patricktokeeffe/rea-nh3-sampler/doc/images/tubing_connections.png

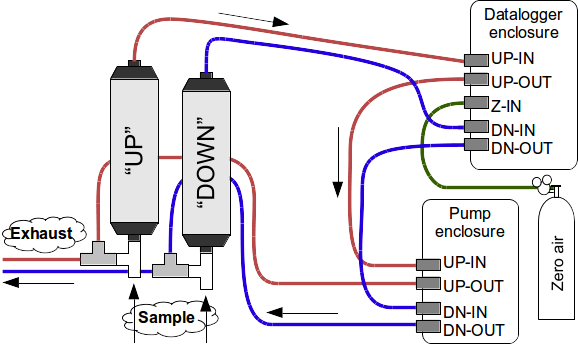
doc/images/tubing_connections.png
