patricktokeeffe/rea-nh3-sampler/doc/images/valve_detail.png

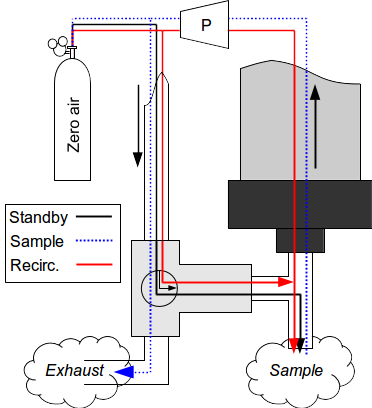
doc/images/valve_detail.png
