patricktokeeffe/rea-nh3-sampler/doc/bill_of_materials.ods

Bill of Materials |  |  | to verify
 | Quantity | Description | Model/Part # | Vendor (Mnfctr, if diff.) | Location
 | 1 | Anemometer, 3D ultrasonic | CSAT3 | Campbell Scientific Inc | Logan, UT
 | 1 | Infrared CO2/H2O analyzer, open-path | LI-7500 | LI-COR Inc. | Lincoln, NE
 | 1 | Temperature/relative humidity probe | HMP45AC | Campbell Scientific Inc (Vaisala) | Logan, UT
 | 1 | Pump, dual-head | R221-AT-AA1 | Air Dimensions | Deerfield Beach, FL
 | 2 | Flow controller, thermal/mass-based, 0-10 sLPM |  | Omega
 | 1 | Flow controller, thermal/mass-based, 0-0.5 sLPM |  | Omega
 | 2 | Valve, solenoid, 3-way, 12V, fast-acting | 091-0094-900 | Parker Hannifin Corp. | Cleveland, OH
 | 1 | Valve, solenoid, 2-way NC, 12V | C-01367-70 | Cole Parmer | Vernon Hills, IL
 | 2 | Tee, PTFE, 1/4 tube x 1/8 MNPT x 1/4 tube | K-31320-35 | Cole Parmer | Vernon Hills, IL
 | 2 | Fitting, quick-disconnect | K-31404-09 | Cole Parmer | Vernon Hills, IL
 | 1 | Datalogger | CR5000 | Campbell Scientific Inc | Logan, UT
 | 1 | Power supply, 13.8Vdc, 10A | ? | Radioshack
 | 1 | Relay rack, 4ch | G4PB4R | Opto 22 | Temecula, CA
 | 4 | Relay, 5Vdc / 60Vdc | G4ODC5 | Opto 22 | Temecula, CA
 | 1 | Relay, solid state, 3-32Vdc / 10A @ 120Vac | 120D10 | Opto 22 | Temecula, CA
 | 1 | Pressure sensor, 0-15 psig, 0-5V | PX309-015G5V | Omega (Omegadyne Inc) | Stamford, CT
 | For pair of housings and four pairs of denuders:
 | 2 | Inlet Cap | 30-006127 | Thermo Scientific | Waltham, MA
 | 2 | PM2.5 inlet, 10L/min, PTFE | 55-006038-T100 | Thermo Scientific | Waltham, MA
 | 2 | Impactor plate | 55-006040 | Thermo Scientific | Waltham, MA
 | 2 | Long length housing (holds 5) | 55-008909 | Thermo Scientific | Waltham, MA
 | 4 | Honeycomb denuder, glass | 55-006171 | Thermo Scientific | Waltham, MA
 | 6 | Stand-off, glass | 24-006041 | Thermo Scientific | Waltham, MA
 | 10 | Spacer, nylon | 36-006042 | Thermo Scientific | Waltham, MA
 | 2 | Spring | 30-006044 | Thermo Scientific | Waltham, MA
 | 6 | 47mm filter stage assembly, Teflon | 55-006169 | Thermo Scientific | Waltham, MA
 | 2 | 47mm filter holder, thread exit | 36-006048 | Thermo Scientific | Waltham, MA
 | 2 | Filter holder housing (outlet) | 55-006049-0004 | Thermo Scientific | Waltham, MA
 | 2 | Male fitting for thread exit | 32-003178 | Thermo Scientific | Waltham, MA
 | 2 | Outlet plug | 30-006128 | Thermo Scientific | Waltham, MA
