patricktokeeffe/rea-nh3-sampler/doc/images/system_components.png

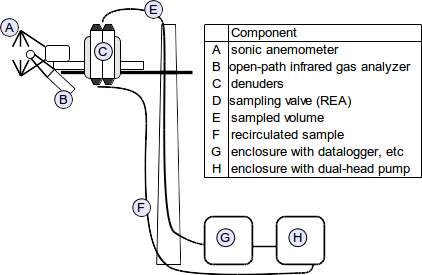
doc/images/system_components.png
