patricktokeeffe/rea-nh3-sampler/engr/MFC_backplane.dxf

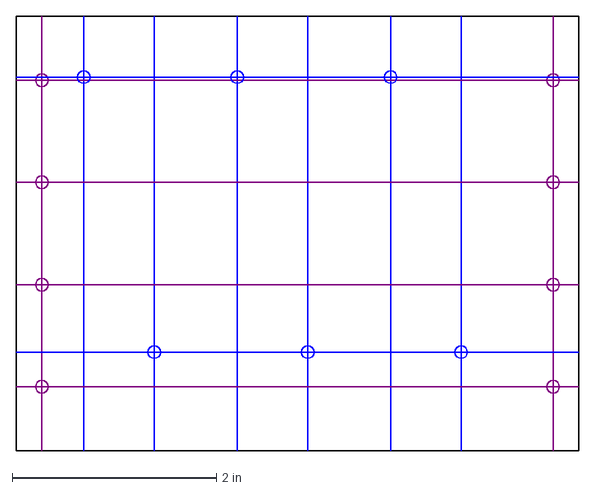
[picture p4: CAD file, 2014-02-12]
engr/MFC_backplane.dxf
5.50 x 4.25 in
