patricktokeeffe/rea-nh3-sampler/doc/wiring_table_insert.ods

 | User-facing Connections
 | Sensor | Description | Color | CR3000 | 13.8 V supply
This sensor is required | Temp/RH (Vaisala HMP 45A/C) | temp signal | yellow | DF 11 H
 |  | RH signal | blue | DF 12 H
 |  | signal ref | white | D11L+D12L
 |  | power supply | red | 12V
 |  | power ground | black | G
 |  | shield | bare | G
Either use these two... | Sonic (Campbellsci CSAT3) | SDM data | green | SDM-C1
 |  | SDM clock | white | SDM-C2
 |  | SDM enable | brown | SDM-C3
 |  | SDM ground | black | G
 |  | SDM shield | bare | G
 |  | power supply | clear |  | pos. (+)
 |  | power ground | black |  | neg. (-)
 | IRGA (Licor LI7500A) | SDM trigger | gray | SDM-C1
 |  | SDM data | blue | SDM-C2
 |  | SDM clock | brown | SDM-C3
 |  | SDM ground | black | G
 |  | shield | white | G
 |  | power supply | red |  | pos. (+)
 |  | power ground | black |  | neg. (-)
 |  | shield | bare |  | neg. (-)
...or use a combined sensor | Sonic + IRGA (Campbellsci EC100/EC150 + CSAT3A) | SDM trigger | ? | SDM-C1
 |  | SDM data | ? | SDM-C2
 |  | SDM clock | ? | SDM-C3
 |  | SDM ground | black | G
 |  | SDM shield | bare | G
 |  | power supply | red |  | pos. (+)
 |  | power ground | black |  | neg. (-)
