patricktokeeffe/rea-nh3-sampler/(commit log)

2014-02-12 Add wiring table
2014-02-12 Add spreadsheet of component parts
    [REA Parts List.xls]
2014-02-12 Add power calc spreadsheet
    [instrument power.xlsx]
2014-02-12 Replace wiring table with user-oriented spreadsheet-based version, update too
    [wiring table insert.ods]
2014-02-12 Add borders for legibility
    [wiring table insert.ods]
2014-02-12 Update wiring diagram
    [wiring table insert.ods]
2014-02-12 Initial revisions to current wiring details
2014-02-12 Fix REA valves triggering before pump activates
2014-02-12 Add MFC backplane CAD template
    [MFC_backplane.dxf]
2014-02-12 Update wiring diagram enclosure insert
    [wiring table insert.ods]
2014-02-12 Update location of pressure sensor analog input
2014-02-12 Check in new schematic documents
    [denuder REA schematic.sch]
2014-02-12 Abstract MFC I/O to Consts, update to reflect Aalborg->Omega switch
2014-02-12 FIX modify sampling valve control to occur real-time in measurement scan
    Previous method using WriteIO causes valve switching to occur in processing
    steps which can lag measurement scan
2014-02-12 Abstract I/O for T/RH sensor
2014-02-12 FIX do not let makeup flow be set to NAN; adds default, min, max Constants
2014-02-12 In case of no sonic data, set both sample valves to recirculate
2014-02-12 Clarify units of gas flow
2014-02-12 Update valve status totals in stats table
    New column tracks 'deadband activations' and existing columns totalling
    up- & down-valve activations are named more clearly
2014-02-12 FIX analog read mode for make up air flow signal
2014-02-12 Update analog input locations for mass flow controllers
2014-02-12 Add variables reflecting control ports used for MFC valve purge signal
2014-02-12 FIX regression causing up valve to activate in place of down valve
2014-02-12 Remove Vaisala pressure transducer from program
    The PTB101 was observed to be unresponsive yesterday; was removed today.
    Pressure still available from open-path infrared gas analyzer.
2014-02-12 Clean up makeup flow calculation
2014-02-12 Add Constant to conditionally use CF card
    Makes debugging more sane; no 'warning card missing' interruptions
2014-02-12 Remove static logic regarding zero MFC valve OFF status
2014-02-12 Add (disabled) logic to activate MFC power 1min prior to run start
    Not used because zero MFC stays on 24/7 providing clean flush air to prevent
    ambient air incursion while denuders wait for run to start. This behavior may
    change in the future
2014-02-13 Replace spaces in file names with underscores
    [REA_Parts_List.xls, instrument_power.xlsx, schematic.sch, wiring_table_insert.ods]
2014-02-13 Update formatting of parts list
    [REA_Parts_List.xls, bill_of_materials.ods]
2014-02-26 Add diagram of denuder+inlet valve with flow paths
2014-02-26 Add template workbook for reducing denuder assay data
    [Denuder_assay_workbook.xlsx]
2014-03-04 Add pressure sensor for zero air monitoring to bill of materials
    [bill_of_materials.ods]
2014-03-04 Add 'standby mode' flow path to detailed flow diagram
2014-03-05 Update denuder assay workbook
    - simplifies dilution calculations
    - subtracts mean control mass, not conc., from samples
    - removes test data
    [Denuder_assay_workbook.xlsx]
2014-03-05 New program framework compilable once more, in-place thru cov calcs
2014-03-05 Expose ConstTable via menu; updates defaults, enables sensor selection
2014-03-06 Calculate, store valve activation ratios in output data tables
2014-06-06 Add parallel framework to retain schedule settings to file
2014-06-09 FIX: interpret case of '100' as a "long time" (e.g. 01:00)
2014-06-11 Track shield flow state and if set by user return to last state at startup
2014-06-11 Prevent disabling shield flow while run is queued
2014-06-11 Turn on/off MFC power, set MFC valve state according to running state
2014-06-11 Set up/down sampling valve state according to running state
2014-06-11 Set sample flow rate & detect difference to trigger down-throttling
2014-06-12 Use temperature from IRGA if available to calculate Obukhov length
2014-06-12 Revise footprint estimate function, add calculation
2014-06-12 Activate pump when conducting a run
2014-06-12 FIX: properly save current state of shield flow
2014-06-24 Track rotated vertical wind speed in `ts_fast` table
    The rotated wind speed is used for valve activation, thus this is useful
    value to record
2014-06-24 Add dew point temperature calculation
2014-06-24 Add function for calculating mass->volumetric flow rate
2014-06-25 Be more specific about variable representation in 10hz table
2014-06-26 TST/FIX: revert sentinel boolean to false when up/dn flows are equal
2014-06-26 Record 30min flows/valve state in `stats` table for the meantime
2014-07-08 Abstract out listing support for CRBasic language
    [lstlocal.cfg]
2014-07-08 Add/revise cover & inside flap material
    - Replaced static date with as-published-date macro
    - Extend project credit to partner department
    - Add repository & project page info box
2014-07-08 FIX: add missing unit to sampling flow setting
2014-07-09 Adjust scaling of EC150 values to match constants used by device
2014-07-09 Enable logger tmpr & voltage variables
2014-07-09 FIX/DOC: review & verify Hsieh 70% footprint estimate
2014-07-10 Implement real-time calc of volumetric flow rate & half-hour means
2014-07-10 DOC: overhaul data products chapter to reflect current data tables
2014-07-11 Only auto-throttle sample setpoints when set automatic & is running
2014-07-11 DOC: overhaul sections on operation/settings/sensor config
2014-07-15 ENH: calculate valve activation ratios each half-hour
2014-07-17 fixup! ENH: calculate valve activation ratios each half-hour
2014-07-18 FIX: correct a serious wiring inconsistency with MFCs
2014-07-18 Sample deadband with other half-hour values
2014-07-18 FIX: be more explicit in valve activation counting
    Previous method of summing boolean values resulted in absurdly large
    totals; new method ensures each activation is counted as 1
2014-07-18 TST: wire up `itt` function with tracer return values
    Value saved in half-hour file is always 0 for this column. Why is
    entirely unclear.
2014-07-18 FIX: non-calculation of some half-hour values
    Mean flow rates in half-hour table were not being calculated because
    table was being called within half-hour processing block and therefore
    no records were being included
2014-07-18 Reduce data type size for most variables in half-hour data table
    Doesn't have major impact on memory card capacity but does reduce
    half-hour file size by ~50% and removes impression of false precision
2014-07-18 ENH: add standard deviation of mass flow rates to half-hour table
2014-07-18 TST/ENH: re-enable autothrottle but set lower limit of 60% target flow rate
2014-07-20 FIX: apply valve activating totaling fix to `rea` table
2014-07-20 Finish up autothrottle functionality
    Concept works OK so
    - smooth out response (shorter mean, lower throttle rate)
    - add user setting for lower throttling bound
    - remove test code
    - update documentation
2014-07-20 TST: remove tracers from `itt` function
    Testing generated 666, 777, 888 values in half-hour file so works
    as expected -- earlier results still unexplained.
2014-07-20 Revise half-hour table
    Relocates mass flow rates after REA-related values. Removes valve
    activation intermediate values. Also removes latent heat and mean
    CO2 mass density since they are both very easily re-calculated. Mass
    flow half-hour std. deviations are also dropped since they can be
    recalculated and `rea` table will track std. dev. of volumetric flow
2014-07-20 Improve REA calcs in `rea` table
    Calc up/dn deltas instead of two means. Calc valve activation ratio
    instead of just totals, Add std. dev. of volumetric flow.
2014-07-20 TST: another attempt to fix `itt` problem
    After reverting tracer values, began returning only 0 again.
2014-07-20 FIX: use standard units for roughness length
    Data collected already probably has mistaken footprint calculations
    since users, author included, are familiar with roughness lengths in
    meters: grassy field is ~0.03.
2014-07-21 ENH: streamline valve control & simulated REA calculations
2014-07-21 Implement real-time sonic temperature correction & sensible heat product
    This approach of calculating sensible heat with the influence of water
    removed is derived from the REACCH eddy covariance tower monitoring
    program.
2014-07-21 Re-implement sensible heat flux correction
    This approach of calculating actual sensible heat flux based on naive
    sensible heat flux from sonic temperature is re-implemented from the
    original program by Jay Ham.
2014-07-21 FIX: correct valve activation summing calcs in `rea` table
2014-07-22 FIX: correct the real-time calc of 'corrected' sonic temperature
    Was missing scaling of sonic temp degC -> Kelvin.
2014-07-23 FIX/DOC: temporarily disable frame around source code listing
    The `framed` package apparently can't handle files >1704 lines so the
    user manual has been uncompilable for the past half-dozen commits.
2014-07-24 TST: add tracers throughout calculation of `itt`
    Very seriously suspect a legitimate bug within datalogger OS (wouldn't
    be the first one found).
2014-07-29 TST: remove `itt` tracers and revert to function
    With calc broken up to access tracer values, proper results are returned
    so decompose calc within function.
2014-07-30 FIX/DOC: condense program to fit within user manual appendix
    The `framed` package is used to produce unbroken frames around
    the program source code listing. It has a limit of 1704 lines though
    so condense program file by removing white space and comments.
